sehrgutesoftware/splitflap/3d/flap_characters.scad

character_list = " 0123456789-,.*%+<=>$BEx";
function get_character_list() = character_list;
