sehrgutesoftware/splitflap/(list of files, cad)

Other CAD files:
3d/flap_dimensions.scad
