sehrgutesoftware/splitflap/electronics/sensor_smd/sensor_smd.kicad_pcb

## KiCad design electronics/sensor_smd/sensor_smd.kicad_pcb (2025-10-30)

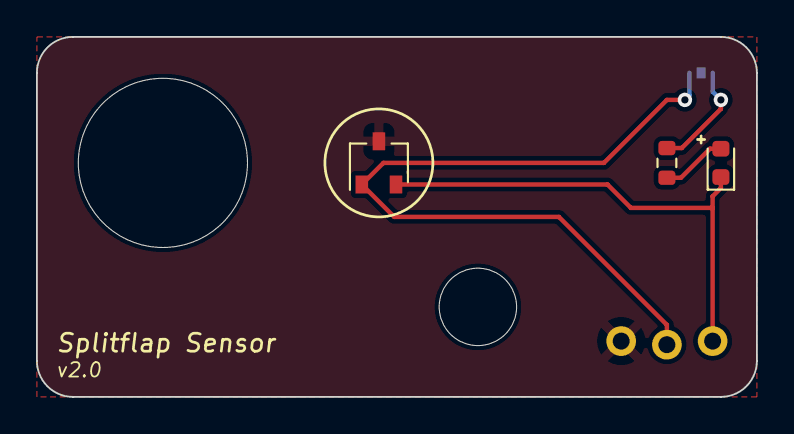
[picture p1: board sensor_smd.kicad_pcb from above]

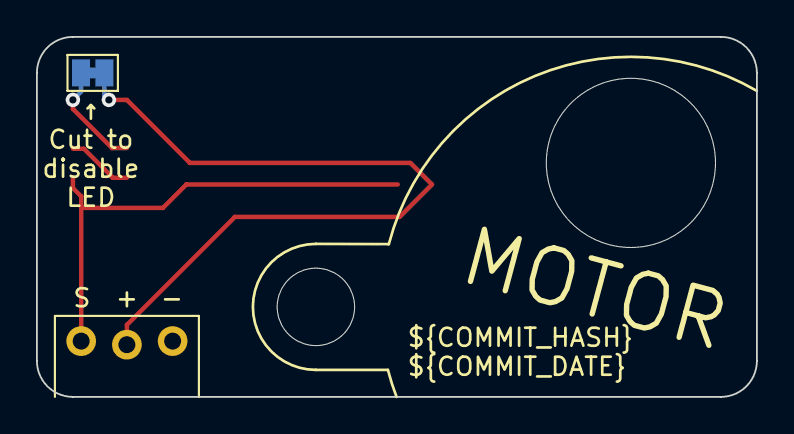
[picture p2: board sensor_smd.kicad_pcb from below]

Board: 2 copper layers, 40.0 x 20.0 mm, 7 parts (2 on the bottom side), 5 nets.

Parts:
D1: LED RED; LED_0603_1608Metric
H1: MountingHole; MountingHole_4.3mm_M4_ISO7380
H2: MountingHole; hole_9.4
J1: HEADER MALE RA; header_3
JP1: LED enable; SolderJumper-2_P1.3mm_Bridged_Pad1.0x1.5mm
R1: 1k; R_0603_1608Metric
U1: HX6286; SOT-23W

Connections:
/SIGNAL: D1.1 (K), J1.1, U1.2 (VOUT)
GND: J1.3, U1.3 (GND)
unnamed: D1.2 (A), R1.1
unnamed: JP1.2 (B), R1.2
VDD: J1.2, JP1.1 (A), U1.1 (VCC)
