sehrgutesoftware/splitflap/(commit log)

2025-10-11 Fix many missing images in v2 Assembly.md
2025-10-11 Fix more images in v2 Assembly guide
2025-10-30 Replace axle with a 3D part and add a bearing
    This allows us to reduce the diameter of the axle to allow for
    a lower flap count without the axle interfering with the flaps.
    It also should reduce friction and therefore load on the stepper
    motor. This allows us to increase flap size without overloading
    the stepper motor.
    [splitflap.scad]
2025-10-30 Add optional front panel mounting holes
    [splitflap.scad]
2025-10-30 Introduce motor_angle variable to rotate the stepper about its shaft
    [splitflap.scad]
2025-10-30 Move hall effect sensor further in to allow for smaller spools
    [sensor_pcb_dimensions.scad, sensor_smd.kicad_pcb, splitflap.scad]
2025-10-30 Add 3D parts render mode to export 3D parts (spool axle)
    [splitflap.scad]
2025-10-30 Change dimensions to produce 24 flaps of 4xCR80 size
    [flap_characters.scad, flap_dimensions.scad, splitflap.scad]
2025-10-30 Fix 2D rendering arrangement
    [splitflap.scad]
2025-10-30 Fix motor shaft in spool axle
    [splitflap.scad]
2025-11-01 Implement 'directory of SVGs' font
    [flap.scad, flap_3dp.scad, flap_fonts.scad]
2025-11-01 Define flap font, characters & colors for VV
    [flap.scad, flap_characters.scad, flap_fonts.scad]
2025-11-02 Adjust flap dimensions (thickness and pin width)
    [flap.scad, flap_dimensions.scad, splitflap.scad]
2025-11-02 Add option to flip odd 3dp flaps
    FDP 3D printing produces different-looking top and bottom
    surfaces. This option allows to achieve visual consistency
    at least within a single character.
    By flipping odd flaps upside down, the two halves of an individual
    character both either face the build plate or away from the build
    plate.
    [flap.scad, flap_3dp.scad]
2025-11-02 Fix M4 nut slot in axle (too much radial tolerance)
    [splitflap.scad]
2025-11-02 Set kerf_width=0.2mm
    [splitflap.scad]
2025-11-02 Set front_window_overhang = 2 (was 1)
    [splitflap.scad]
2025-11-02 Set font_extrusion_3d = 0.2
    [flap.scad]
2025-11-04 Adjust plain-color flaps (black & white)
    [flap.scad, flap_fonts.scad]
2025-11-04 Set flap thickness to .6mm
    [flap_dimensions.scad]
2025-11-05 Add spool spacer to prevent axial movement of the spool
    [28byj-48.scad, splitflap.scad]
2025-11-08 Fix SVG font rendering (don't center) and VV font
    [flap.scad, flap_fonts.scad]
2025-11-09 Fix y offset for SVGs in VV font
    [flap_fonts.scad]
2025-11-16 Expose the serial protocol via a TCP socket; add ethernet support
2025-11-16 Add tabs to connect front and sides
    [splitflap.scad]
2025-11-16 Increase front mounting hole radius
    [splitflap.scad]
2025-11-18 Replace front_window_overhang by a front notch
    [splitflap.scad]
2025-11-18 Decrease enclosure extra width for front mounting holes
    [splitflap.scad]
2025-11-18 Adjust kerf value
    [splitflap.scad]
2025-11-28 Configure the socket to send keepalives
